FrostXia/WSN_Group_Project/docs/GP2Y_BC337.png

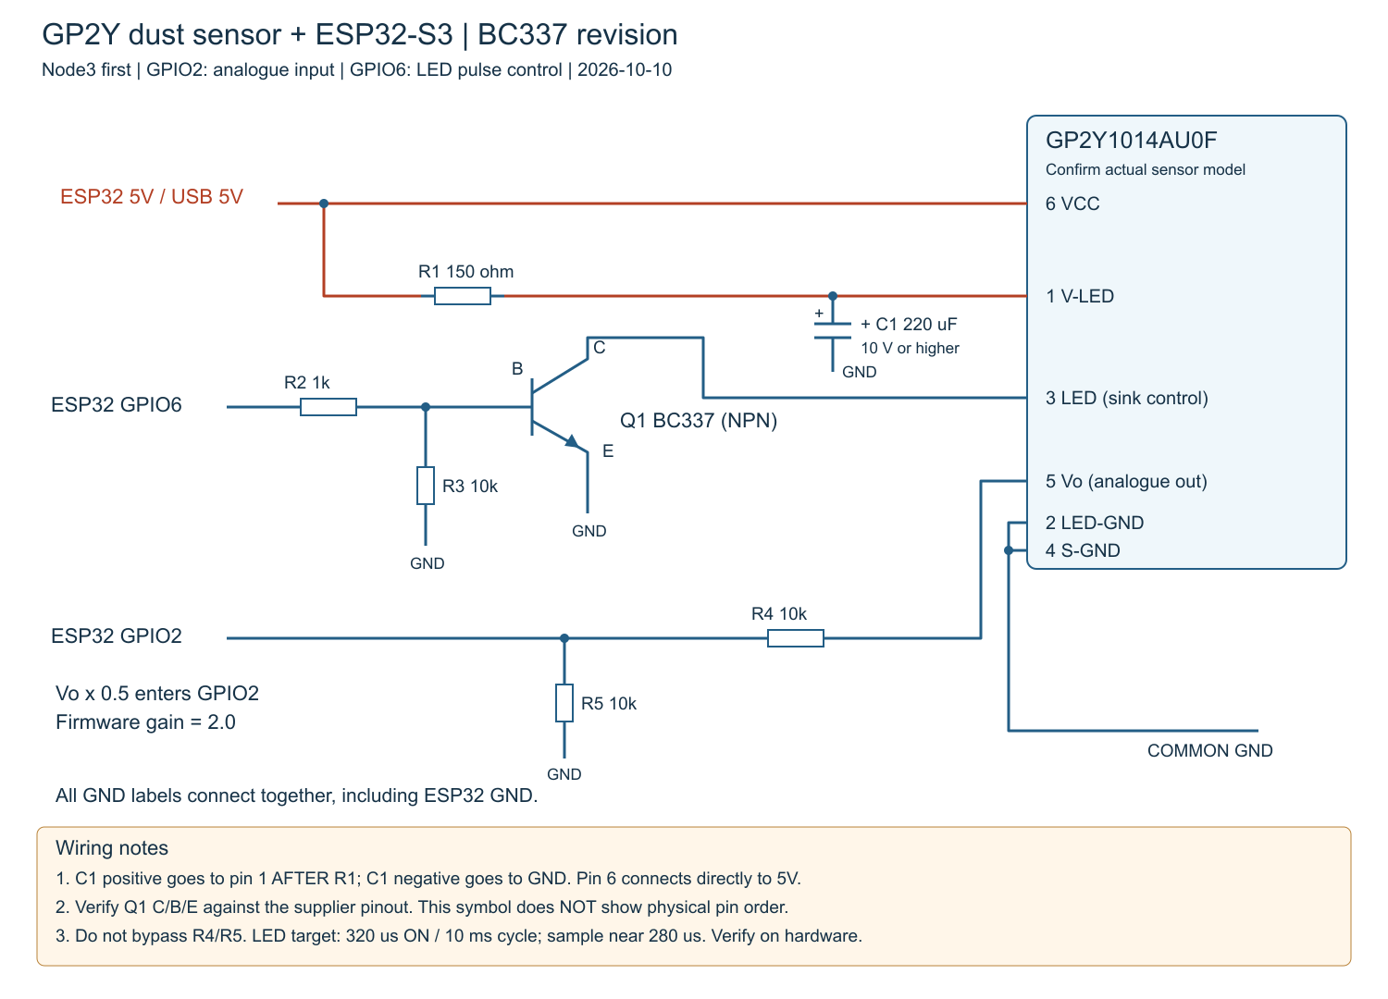
docs/GP2Y_BC337.png
