FrostXia/WSN_Group_Project/requirements-tested.txt

Flask==3.1.3
Werkzeug==3.1.8
Jinja2==3.1.6
MarkupSafe==3.0.3
itsdangerous==2.2.0
click==8.5.0
blinker==1.9.0
pyserial==3.5
